otula71/KRAA1-line-following-robot-analog/pictures/IMG_0264.jpg

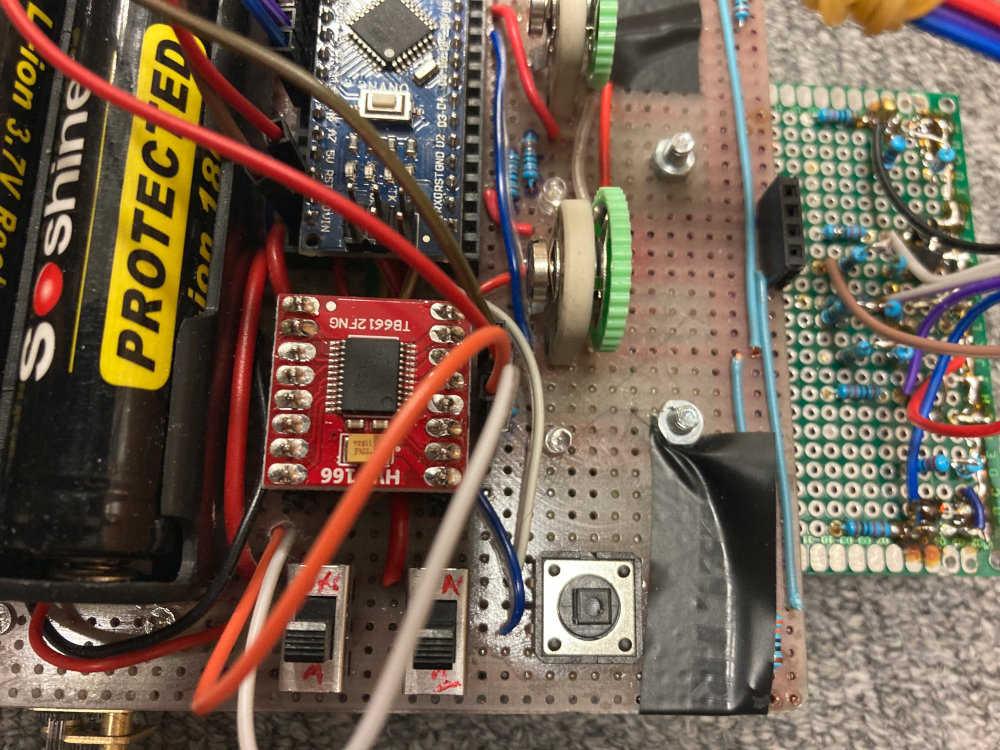
pictures/IMG_0264.jpg
